wrieden/c3dpb/hardware/todo.txt

v1.2
use address mode for tmc2209
increase 100k feedback resistor gap
increase plane distance

v1.1 
add diode to power outputs 			done a
remove silkscreen lines between pinout		done a	
print polarity on top layer			done a
narrow pins on buck footprint			done a 
sot23 footprint too small			done a 
more space between some components		done a
