wrieden/c3dpb/hotend_board/c3dpb.kicad_pcb

## KiCad design hotend_board/c3dpb.kicad_pcb (2023-03-31)

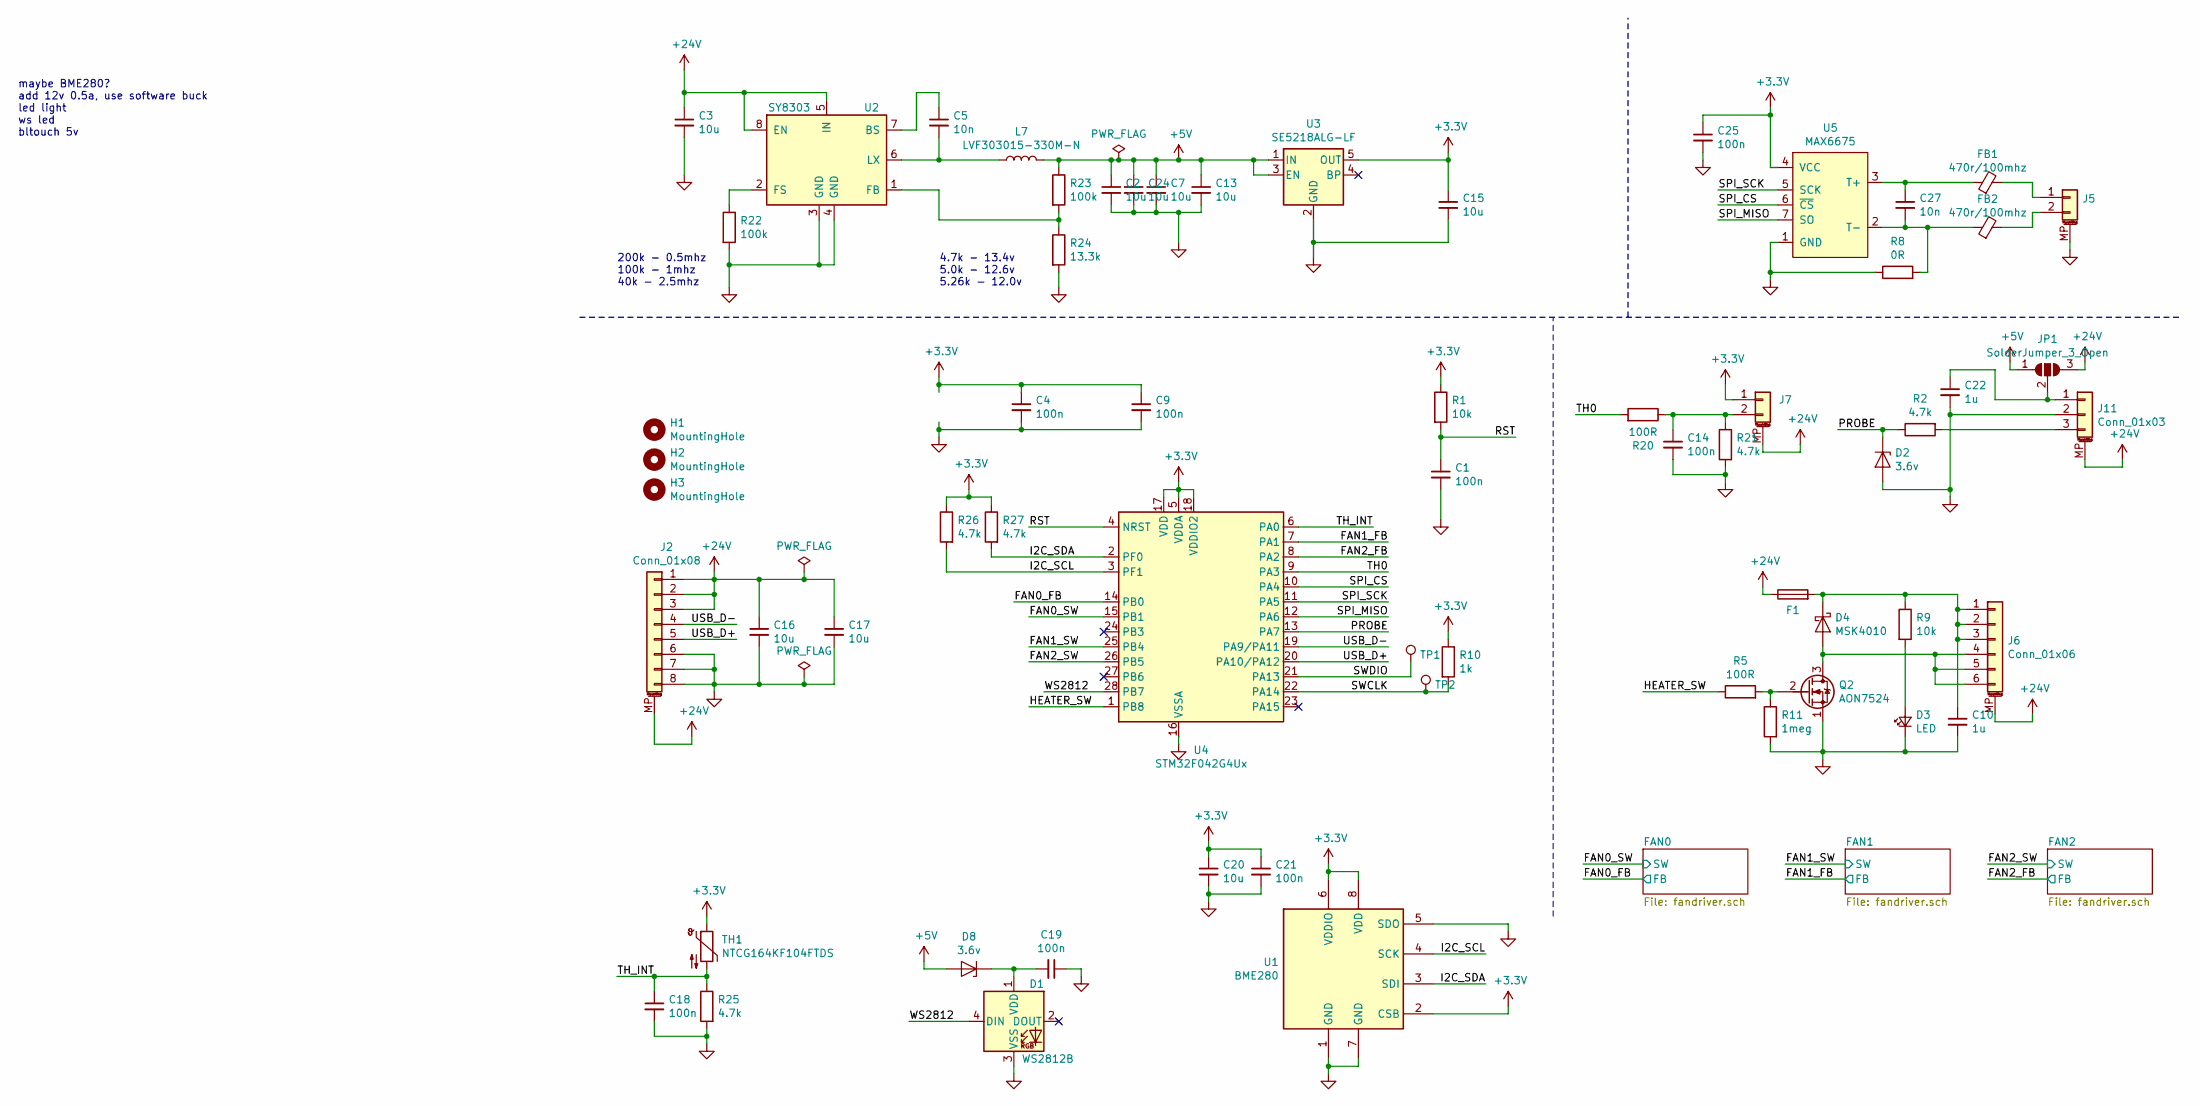
[picture p24: schematic c3dpb.sch, Kajikia - Main Sheet]

Parts:
C1, C4, C9, C14, C18, C19, C21, C25: 100n; 0603_CAP
C2, C7, C13, C15, C20, C24: 10u; 0603_CAP
C3, C16, C17: 10u; 1210_CAP
C5, C27: 10n; 0603_CAP
C10, C22: 1u; 0603_CAP
D1: WS2812B; WS2812B-MINI
D2, D8: 3.6v; 0603_DIODE
D3: LED; 0603_LED
D4: MSK4010; SOD-523_DIODE
F1: Fuse; 1206_RES
FB1, FB2: 470r/100mhz; 0603_IND
H1, H2: MountingHole; MountingHole_2.2mm_M2_ISO7380
H3: MountingHole; MountingHole_4.3mm_M4_ISO14580
J2: Conn_01x08; JST_SH_BM08B-SRSS-TB_1x08-1MP_P1.00mm_Vertical
J5, J7: Conn_01x02; JST_SH_BM02B-SRSS-TB_1x02-1MP_P1.00mm_Vertical
J6: Conn_01x06; JST_SH_BM06B-SRSS-TB_1x06-1MP_P1.00mm_Vertical
J11: Conn_01x03; JST_SH_BM03B-SRSS-TB_1x03-1MP_P1.00mm_Vertical
JP1: SolderJumper_3_Open; Solder Jumper 3P
L7: LVF303015-330M-N; 3x3mm_IND
Q2: AON7524; DFN3x3A_8L_EP1_P
R1, R9: 10k; 0603_RES
R2, R21, R25, R26, R27: 4.7k; 0603_RES
R5, R20: 100R; 0603_RES
R8: 0R; 0603_RES
R10: 1k; 0603_RES
R11: 1meg; 0603_RES
R22, R23: 100k; 0603_RES
R24: 13.3k; 0603_RES
TH1: NTCG164KF104FTDS; 0603_RES
TP1, TP2: TestPoint; TestPoint_Pad_D1.0mm
U1: BME280; Bosch_LGA-8_2.5x2.5mm_P0.65mm_ClockwisePinNumbering
U2: SY8303; TSOT-23-8
U3: SE5218ALG-LF; SOT-23-5
U4: STM32F042G4Ux; QFN-28_4x4mm_P0.5mm
U5: MAX6675; SO-8

Connections:
+3V3: C4.1, C9.1, C15.1, C20.1, C21.1, C25.1, J7.1, R1.1, R10.1, R26.1, R27.1, TH1.1, U1.2 (CSB), U1.6 (VDDIO), U1.8 (VDD), U3.5 (OUT), U4.5 (VDDA), U4.17 (VDD), U4.18 (VDDIO2), U5.4 (VCC)
+5V: C2.1, C7.1, C13.1, C24.1, D8.2 (A), JP1.1 (A), L7.2, R23.1, U3.1 (IN), U3.3 (EN)
+24V: C3.1, C16.1, C17.1, F1.1, J2.1, J2.2, J2.3, J2.MP (MountPin), J6.MP (MountPin), J7.MP (MountPin), J11.MP (MountPin), JP1.3 (B), U2.5 (IN), U2.8 (EN); also elsewhere on the board
/FAN0_FB: U4.14 (PB0); also elsewhere on the board
/FAN0_SW: U4.15 (PB1); also elsewhere on the board
/FAN1_FB: U4.7 (PA1); also elsewhere on the board
/FAN1_SW: U4.25 (PB4); also elsewhere on the board
/FAN2_FB: U4.8 (PA2); also elsewhere on the board
/FAN2_SW: U4.26 (PB5); also elsewhere on the board
/HEATER_SW: R5.1, U4.1 (PB8)
/I2C_SCL: R26.2, U1.4 (SCK), U4.3 (PF1)
/I2C_SDA: R27.2, U1.3 (SDI), U4.2 (PF0)
/PROBE: D2.1 (K), R2.1, U4.13 (PA7)
/RST: C1.1, R1.2, U4.4 (NRST)
/SPI_CS: U4.10 (PA4), U5.6 (~CS)
/SPI_MISO: U4.12 (PA6), U5.7 (SO)
/SPI_SCK: U4.11 (PA5), U5.5 (SCK)
/SWCLK: R10.2, TP2.1, U4.22 (PA14)
/SWDIO: TP1.1, U4.21 (PA13)
/TH0: R20.2, U4.9 (PA3)
/TH_INT: C18.1, R25.1, TH1.2, U4.6 (PA0)
/USB_D+: J2.5, U4.20 (PA10/PA12)
/USB_D-: J2.4, U4.19 (PA9/PA11)
/WS2812: D1.4 (DIN), U4.28 (PB7)
GND: C1.2, C2.2, C3.2, C4.2, C7.2, C9.2, C10.2, C13.2, C14.2, C15.2, C16.2, C17.2, C18.2, C19.1, C20.2, C21.2, C22.2, C24.2, C25.2, D1.3 (VSS), D2.2 (A), D3.1 (K), J2.6, J2.7, J2.8, J5.MP (MountPin), J11.2, Q2.1 (S), R8.1, R11.2, R21.2, R22.2, R24.2, R25.2, U1.1 (GND), U1.5 (SDO), U1.7 (GND), U2.3 (GND), U2.4 (GND), U3.2 (GND), U4.16 (VSSA), U5.1 (GND); also elsewhere on the board
unnamed: C5.1, U2.7 (BS)
unnamed: C5.2, L7.1, U2.6 (LX)
unnamed: C10.1, D4.1 (K), F1.2, J6.1, J6.2, J6.3, R9.1
unnamed: C14.1, J7.2, R20.1, R21.1
unnamed: C19.2, D1.1 (VDD), D8.1 (K)
unnamed: C22.1, J11.1, JP1.2 (C)
unnamed: C27.1, FB1.1, U5.3 (T+)
unnamed: C27.2, FB2.1, R8.2, U5.2 (T-)
unnamed: D3.2 (A), R9.2
unnamed: D4.2 (A), J6.4, J6.5, J6.6, Q2.3 (D)
unnamed: FB1.2, J5.1
unnamed: FB2.2, J5.2
unnamed: J11.3, R2.2
unnamed: Q2.2 (G), R5.2, R11.1
unnamed: R22.1, U2.2 (FS)
unnamed: R23.2, R24.1, U2.1 (FB)

Notes on the sheet:
maybe BME280? add 12v 0.5a, use software buck led light ws led bltouch 5v
4.7k - 13.4v 5.0k - 12.6v 5.26k - 12.0v
200k - 0.5mhz 100k - 1mhz 40k - 2.5mhz

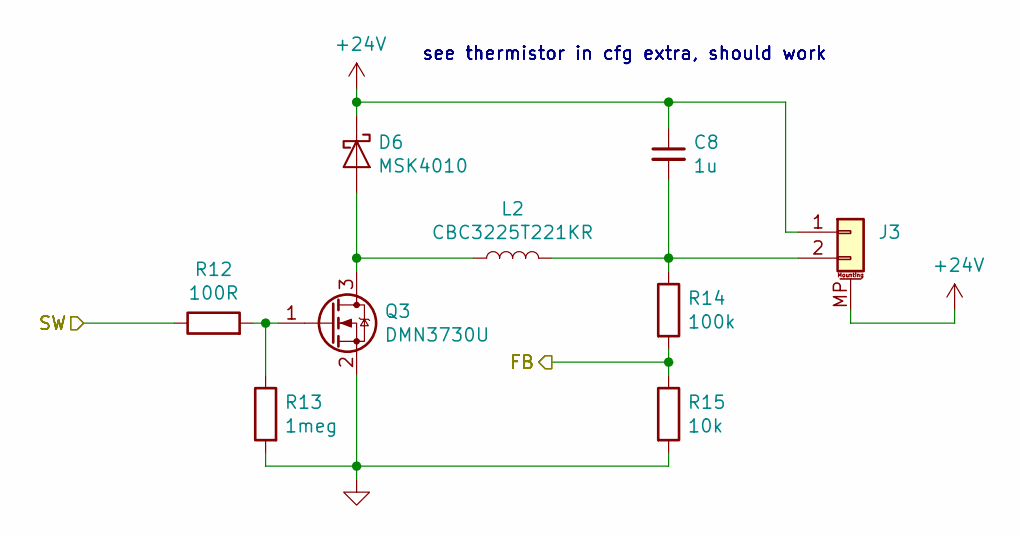
[picture p25: schematic fandriver.sch]

Parts:
C6: 1u; 0603_CAP
D5: MSK4010; SOD-523_DIODE
J1: Conn_01x02; JST_SH_BM02B-SRSS-TB_1x02-1MP_P1.00mm_Vertical
L1: CBC3225T221KR; 1210_CAP
Q1: DMN3730U; SOT-23
R3: 100R; 0603_RES
R4: 1meg; 0603_RES
R6: 100k; 0603_RES
R7: 10k; 0603_RES

Connections:
+24V: C6.1, D5.1 (K), J1.1, J1.MP (MountPin); also elsewhere on the board
/FAN0_FB: R6.2, R7.1; also elsewhere on the board
/FAN0_SW: R3.1; also elsewhere on the board
GND: Q1.2 (S), R4.2, R7.2; also elsewhere on the board
unnamed: C6.2, J1.2, L1.2, R6.1
unnamed: D5.2 (A), L1.1, Q1.3 (D)
unnamed: Q1.1 (G), R3.2, R4.1

Parts of its further copies:
C8, C11: 1u; 0603_CAP
D6, D7: MSK4010; SOD-523_DIODE
J3, J4: Conn_01x02; JST_SH_BM02B-SRSS-TB_1x02-1MP_P1.00mm_Vertical
L2, L3: CBC3225T221KR; 1210_CAP
Q3, Q4: DMN3730U; SOT-23
R12, R16: 100R; 0603_RES
R13, R17: 1meg; 0603_RES
R14, R18: 100k; 0603_RES
R15, R19: 10k; 0603_RES

Connections of its further copies:
+24V: C8.1, C11.1, D6.1 (K), D7.1 (K), J3.1, J3.MP (MountPin), J4.1, J4.MP (MountPin); also elsewhere on the board
/FAN1_FB: R14.2, R15.1; also elsewhere on the board
/FAN1_SW: R12.1; also elsewhere on the board
/FAN2_FB: R18.2, R19.1; also elsewhere on the board
/FAN2_SW: R16.1; also elsewhere on the board
GND: Q3.2 (S), Q4.2 (S), R13.2, R15.2, R17.2, R19.2; also elsewhere on the board
unnamed: C8.2, J3.2, L2.2, R14.1
unnamed: C11.2, J4.2, L3.2, R18.1
unnamed: D6.2 (A), L2.1, Q3.3 (D)
unnamed: D7.2 (A), L3.1, Q4.3 (D)
unnamed: Q3.1 (G), R12.2, R13.1
unnamed: Q4.1 (G), R16.2, R17.1

Notes on the sheet:
see thermistor in cfg extra, should work

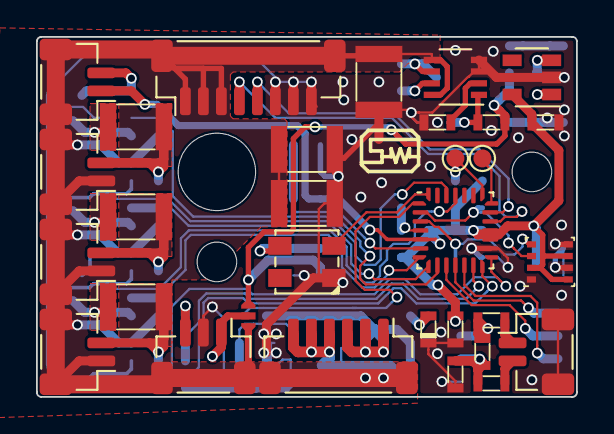
[picture p26: board hotend_board/c3dpb.kicad_pcb from above]

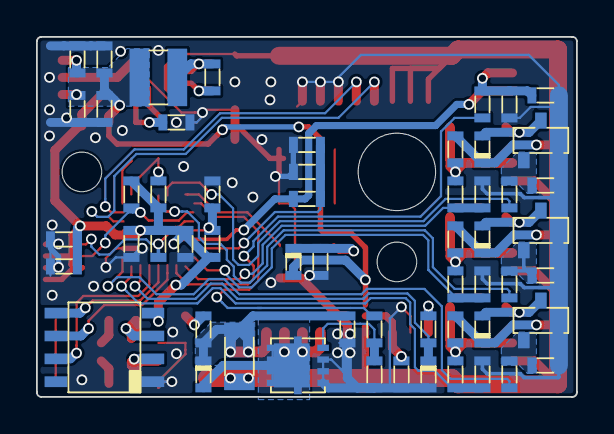
[picture p27: board hotend_board/c3dpb.kicad_pcb from below]

Board: 2 copper layers, 30.0 x 20.0 mm, 90 parts (56 on the bottom side), 50 nets.
