wrieden/c3dpb/hotend_board_mosquito/c3dpb.kicad_pcb

## KiCad design hotend_board_mosquito/c3dpb.kicad_pcb (2023-03-31)

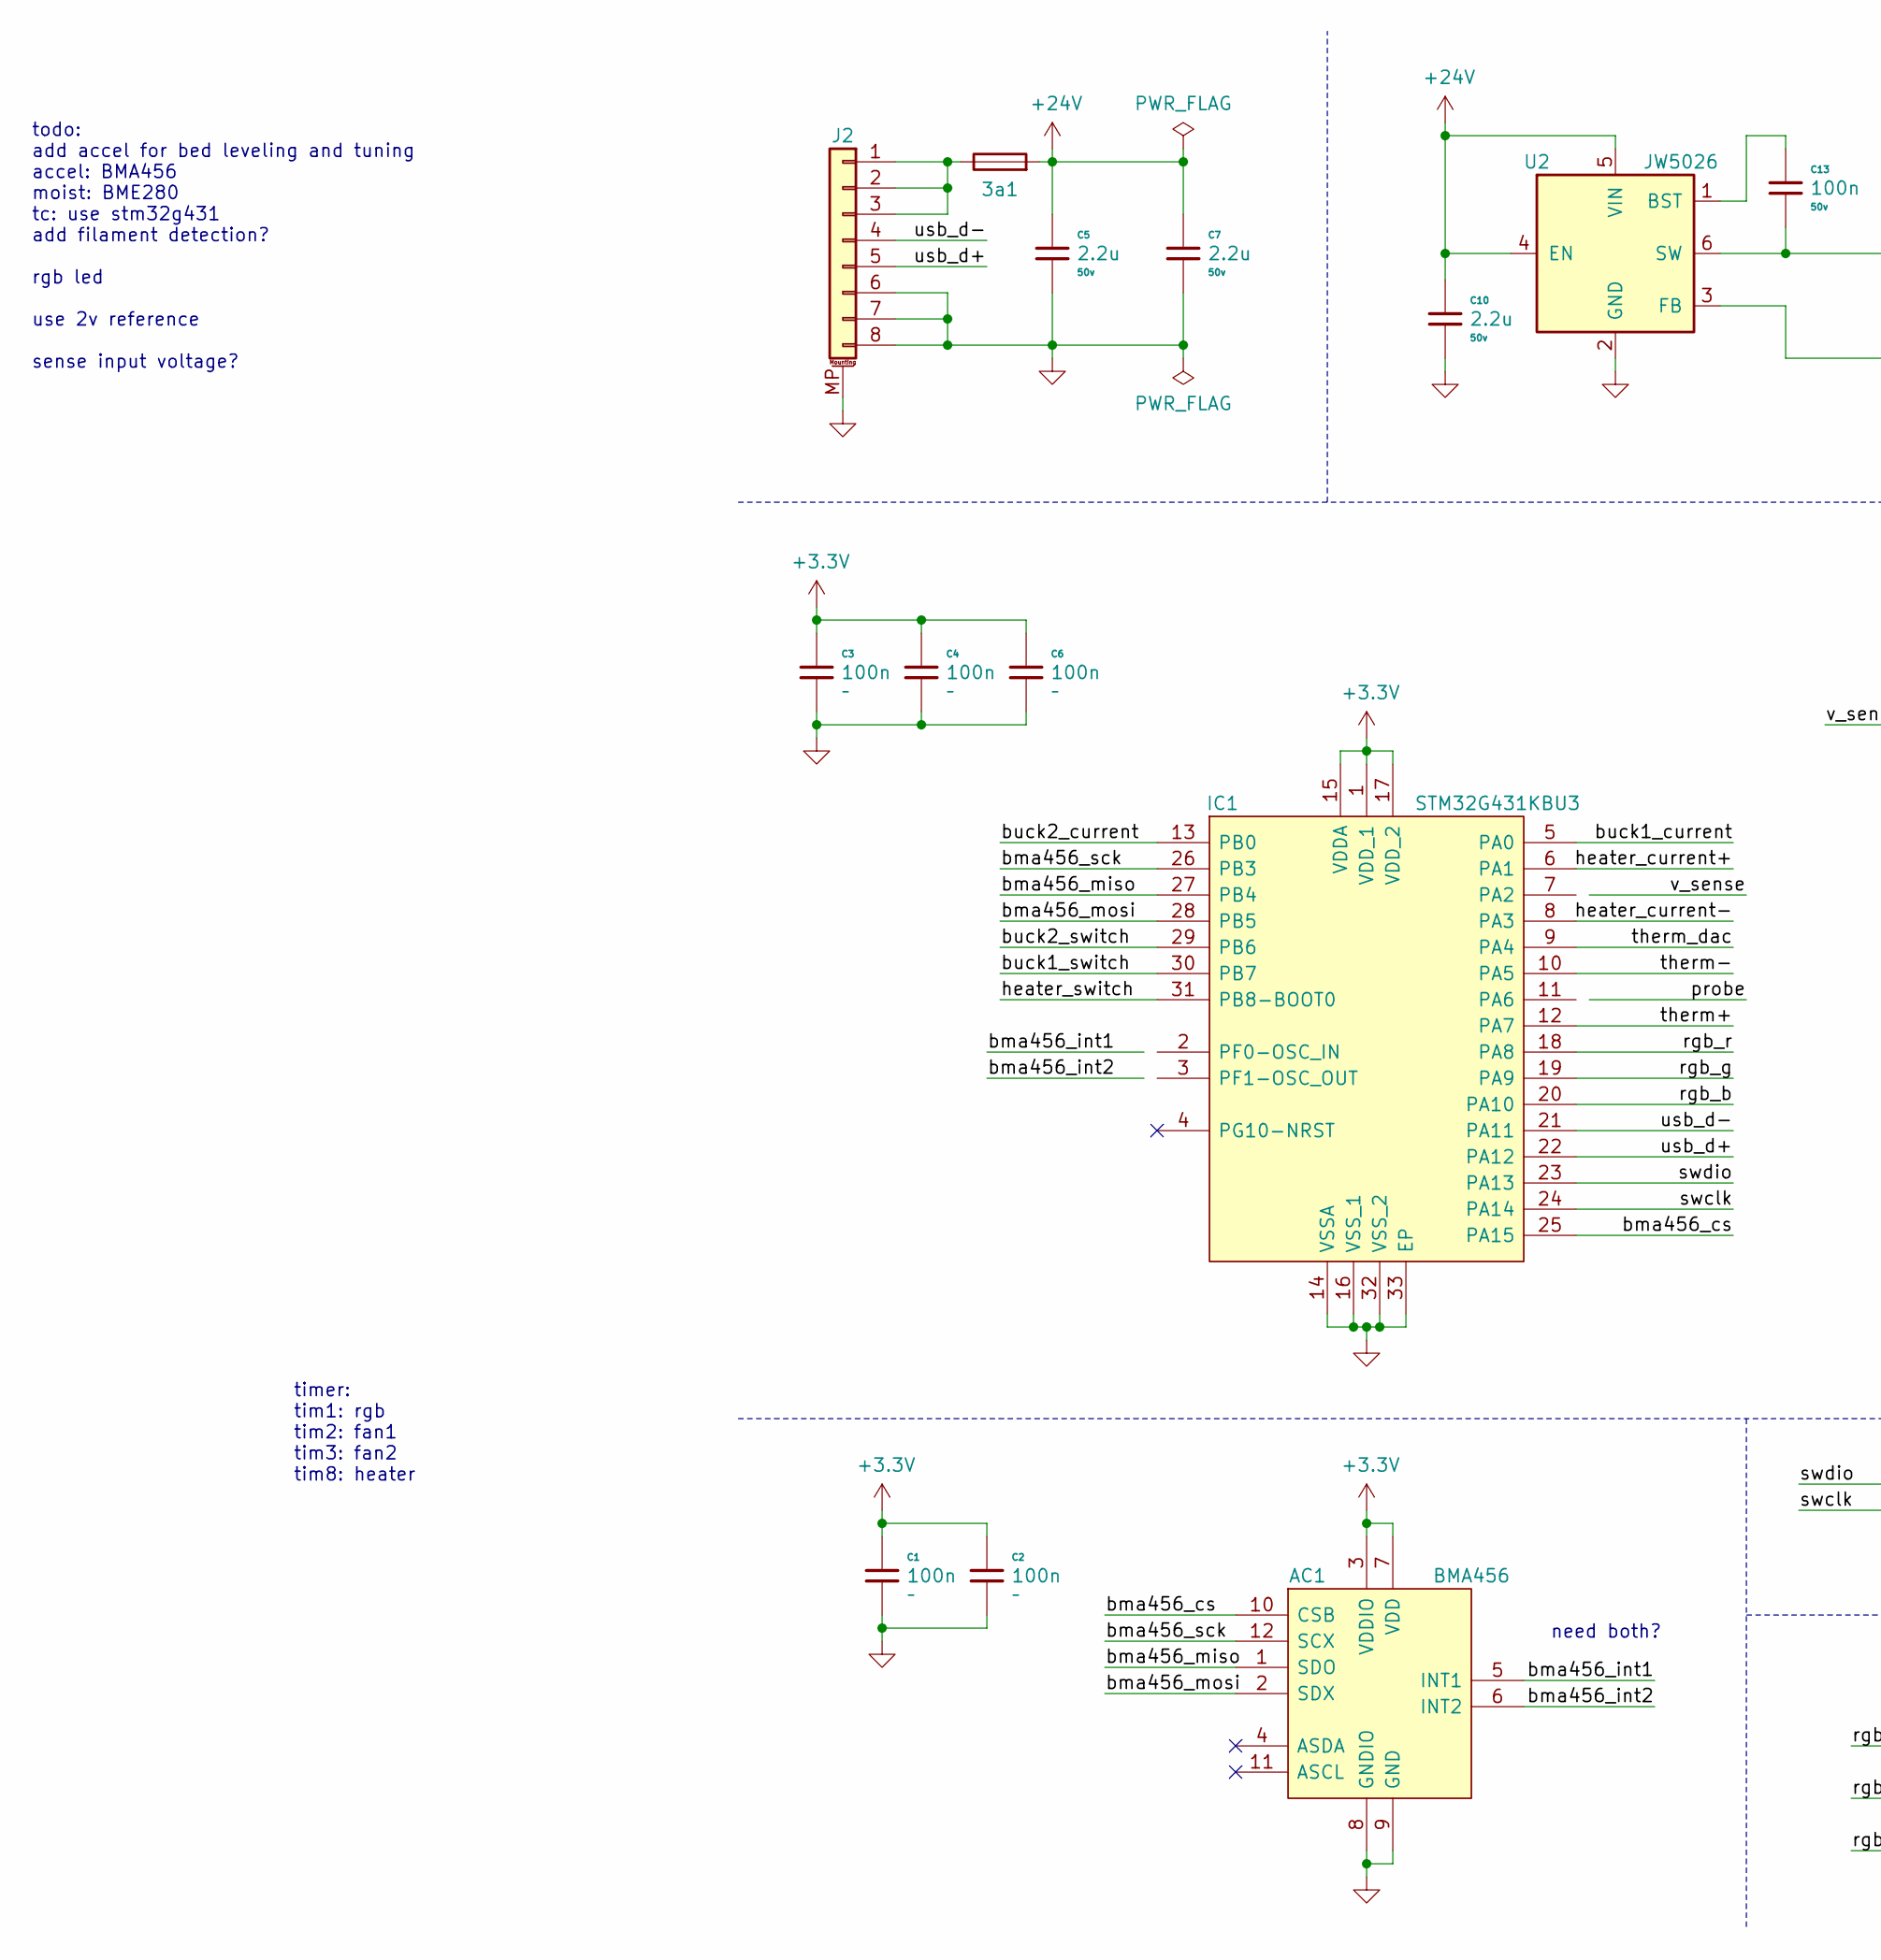
[picture p28: schematic c3dpb.sch, Kajikia - Main Sheet, part in row 1, column 1]

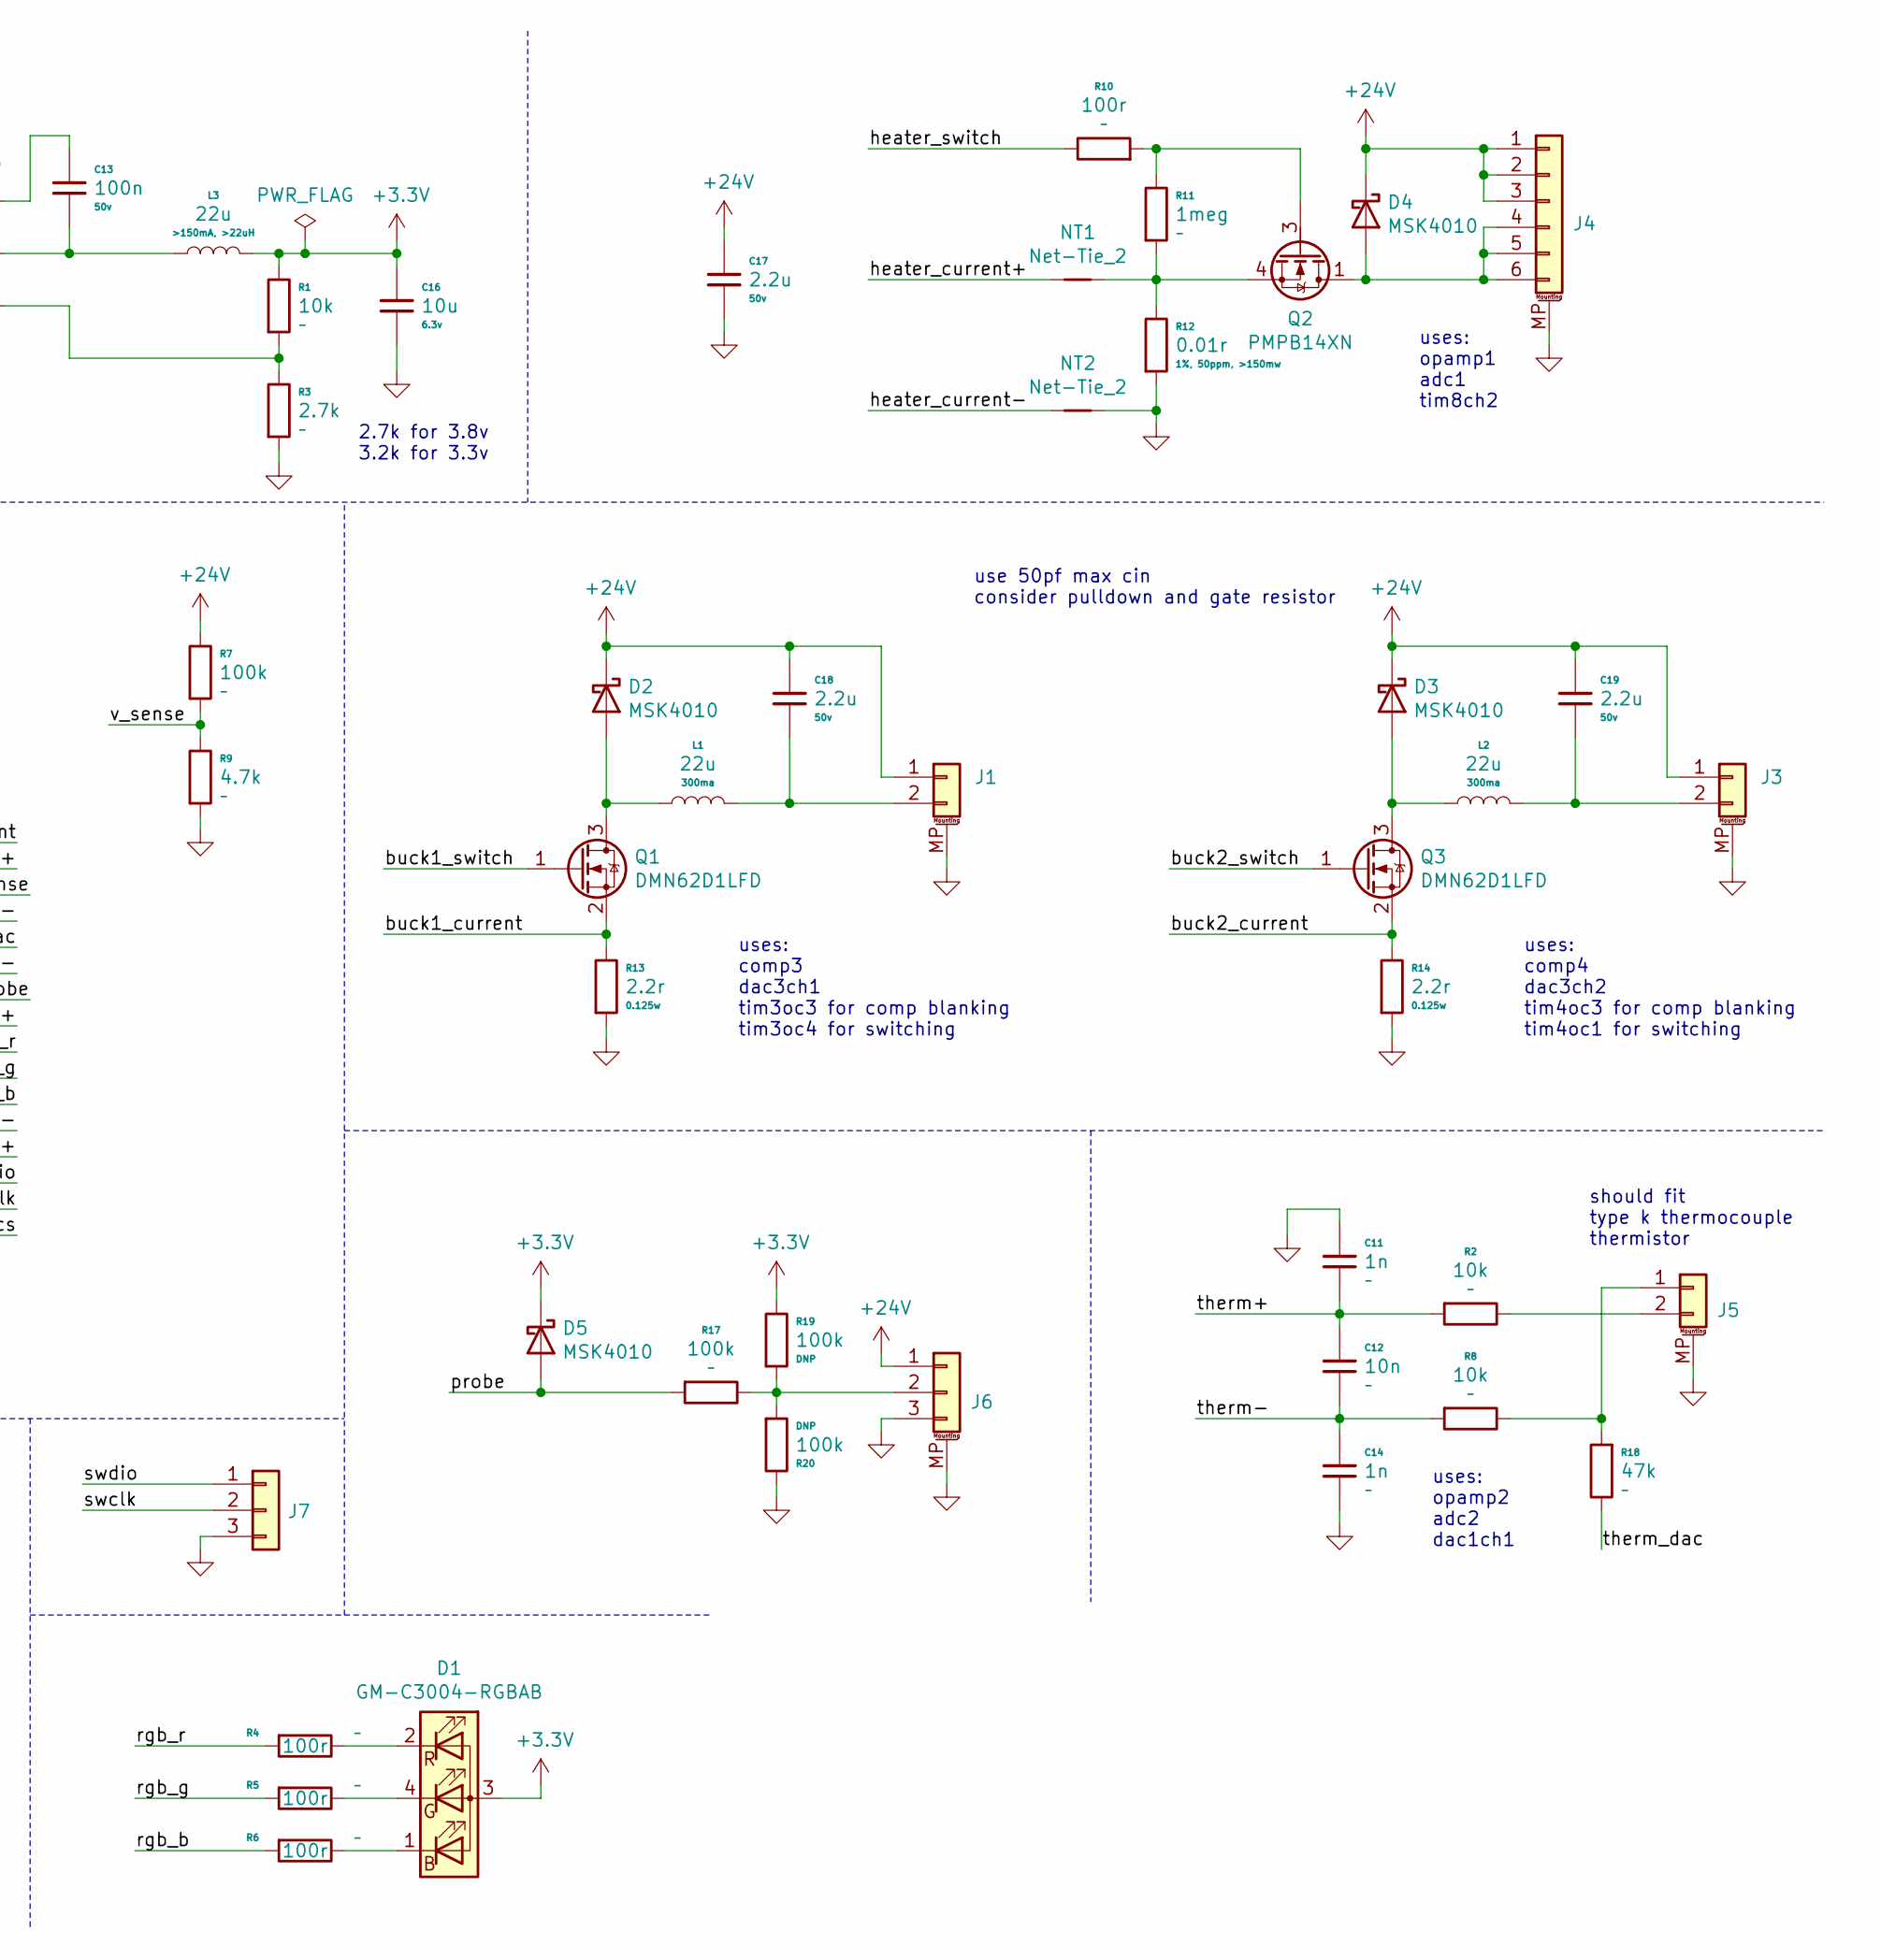
[picture p29: schematic c3dpb.sch, Kajikia - Main Sheet, part in row 1, column 2]

Parts:
3a1: Fuse; 1206_RES
AC1: BMA456; BOSCH_LGA-12
C1, C2, C3, C4, C6, C13: 100n; 0402_CAP
C5, C7, C10, C17, C18, C19: 2.2u; 0603_CAP
C11, C14: 1n; 0402_CAP
C12: 10n; 0402_CAP
C16: 10u; 0402_CAP
D1: GM-C3004-RGBAB
D2, D3, D4, D5: MSK4010; SOD-523_DIODE
IC1: STM32G431KBU3; QFN-32-1EP_5x5mm_P0.5mm_EP3.6x3.6mm
J1, J3: Conn_01x02; JST_SH_BM02B-SRSS-TB_1x02-1MP_P1.00mm_Vertical
J2: Conn_01x08; JST_SH_BM08B-SRSS-TB_1x08-1MP_P1.00mm_Vertical
J4: Conn_01x06_MountingPin; JST_SH_BM06B-SRSS-TB_1x06-1MP_P1.00mm_Vertical
J5: Conn_01x02_MountingPin; JST_SH_BM02B-SRSS-TB_1x02-1MP_P1.00mm_Vertical
J6: Conn_01x03_MountingPin; JST_SH_BM03B-SRSS-TB_1x03-1MP_P1.00mm_Vertical
J7: Conn_01x03; pads_3x1mm
L1, L2, L3: 22u; 0805_IND
NT1, NT2: Net-Tie_2; nettie-1.27
Q1, Q3: DMN62D1LFD; U-DFN1212-3
Q2: PMPB14XN; Diodes_UDFN2020-6_Type-F
R1, R2, R8: 10k; 0402_RES
R3: 2.7k; 0402_RES
R4, R5, R6, R10: 100r; 0402_RES
R7, R17, R19, R20: 100k; 0402_RES
R9: 4.7k; 0402_RES
R11: 1meg; 0402_RES
R12: 0.01r; 0603_RES
R13, R14: 2.2r; 0603_RES
R18: 47k; 0402_RES
U2: JW5026; SOT-23-6

Connections:
+3V3: AC1.3 (VDDIO), AC1.7 (VDD), C1.1, C2.1, C3.1, C4.1, C6.1, C16.1, D1.3 (A), D5.1 (K), IC1.1 (VDD_1), IC1.15 (VDDA), IC1.17 (VDD_2), L3.2, R1.1, R19.1
+24V: 3a1.2, C5.1, C7.1, C10.1, C17.1, C18.1, C19.1, D2.1 (K), D3.1 (K), D4.1 (K), J1.1, J3.1, J4.1, J4.2, J4.3, J6.1, R7.1, U2.4 (EN), U2.5 (VIN)
/bma456_cs: AC1.10 (CSB), IC1.25 (PA15)
/bma456_int1: AC1.5 (INT1)
/bma456_int2: AC1.6 (INT2)
/bma456_miso: AC1.1 (SDO), IC1.27 (PB4)
/bma456_mosi: AC1.2 (SDX), IC1.28 (PB5)
/bma456_sck: AC1.12 (SCX), IC1.26 (PB3)
/buck1_current: IC1.5 (PA0), Q1.2 (S), R13.1
/buck1_switch: IC1.30 (PB7), Q1.1 (G)
/buck2_current: IC1.13 (PB0), Q3.2 (S), R14.1
/buck2_switch: IC1.29 (PB6), Q3.1 (G)
/heater_current+: IC1.6 (PA1), NT1.2
/heater_current-: IC1.8 (PA3), NT2.2
/heater_switch: IC1.31 (PB8-BOOT0), R10.1
/probe: D5.2 (A), R17.2
/rgb_b: IC1.20 (PA10), R6.2
/rgb_g: IC1.19 (PA9), R5.2
/rgb_r: IC1.18 (PA8), R4.2
/swclk: IC1.24 (PA14), J7.2
/swdio: IC1.23 (PA13), J7.1
/therm+: C11.2, C12.1, IC1.12 (PA7), R2.2
/therm-: C12.2, C14.1, IC1.10 (PA5), R8.2
/therm_dac: IC1.9 (PA4), R18.1
/usb_d+: IC1.22 (PA12), J2.5
/usb_d-: IC1.21 (PA11), J2.4
/v_sense: R7.2, R9.1
GND: AC1.8 (GNDIO), AC1.9 (GND), C1.2, C2.2, C3.2, C4.2, C5.2, C6.2, C7.2, C10.2, C11.1, C14.2, C16.2, C17.2, IC1.14 (VSSA), IC1.16 (VSS_1), IC1.32 (VSS_2), IC1.33 (EP), J1.MP (MountPin), J2.6, J2.7, J2.8, J2.MP (MountPin), J3.MP (MountPin), J4.MP (MountPin), J5.MP (MountPin), J6.3, J6.MP (MountPin), J7.3, NT2.1, R3.2, R9.2, R12.2, R13.2, R14.2, R20.1, U2.2 (GND)
unnamed: 3a1.1, J2.1, J2.2, J2.3
unnamed: C13.1, U2.1 (BST)
unnamed: C13.2, L3.1, U2.6 (SW)
unnamed: C18.2, J1.2, L1.2
unnamed: C19.2, J3.2, L2.2
unnamed: D1.1 (BK), R6.1
unnamed: D1.2 (RK), R4.1
unnamed: D1.4 (GK), R5.1
unnamed: D2.2 (A), L1.1, Q1.3 (D)
unnamed: D3.2 (A), L2.1, Q3.3 (D)
unnamed: D4.2 (A), J4.4, J4.5, J4.6, Q2.1 (D), Q2.2 (D), Q2.5 (D), Q2.6 (D), Q2.7 (D)
unnamed: J5.1, R8.1, R18.2
unnamed: J5.2, R2.1
unnamed: J6.2, R17.1, R19.2, R20.2
unnamed: NT1.1, Q2.4 (S), Q2.8 (S), R11.2, R12.1
unnamed: Q2.3 (G), R10.2, R11.1
unnamed: R1.2, R3.1, U2.3 (FB)

Notes on the sheet:
todo: add accel for bed leveling and tuning accel: BMA456 moist: BME280 tc: use stm32g431 add filament detection? rgb led use 2v reference sense input voltage?
timer: tim1: rgb tim2: fan1 tim3: fan2 tim8: heater
should fit type k thermocouple thermistor
need both?
use 50pf max cin consider pulldown and gate resistor
uses: comp4 dac3ch2 tim4oc3 for comp blanking tim4oc1 for switching
uses: comp3 dac3ch1 tim3oc3 for comp blanking tim3oc4 for switching
uses: opamp2 adc2 dac1ch1
uses: opamp1 adc1 tim8ch2
2.7k for 3.8v 3.2k for 3.3v

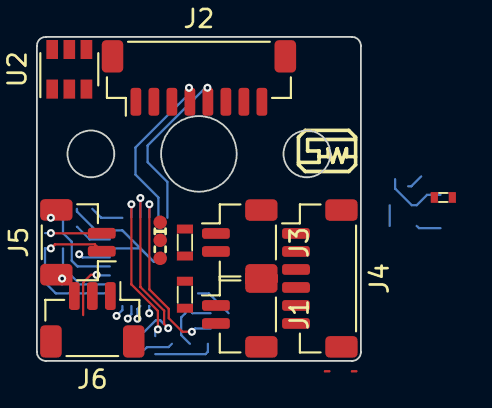
[picture p30: board hotend_board_mosquito/c3dpb.kicad_pcb from above]

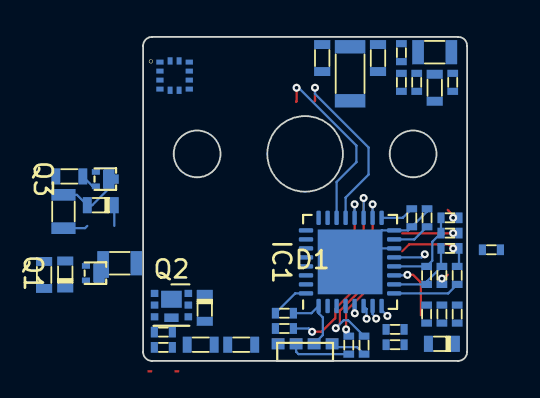
[picture p31: board hotend_board_mosquito/c3dpb.kicad_pcb from below]

Board: 4 copper layers, 18.0 x 18.0 mm, 58 parts (45 on the bottom side), 43 nets.
