wrieden/c3dpb/hardware/c3dpb.kicad_pcb

## KiCad design hardware/c3dpb.kicad_pcb (2020-02-15)

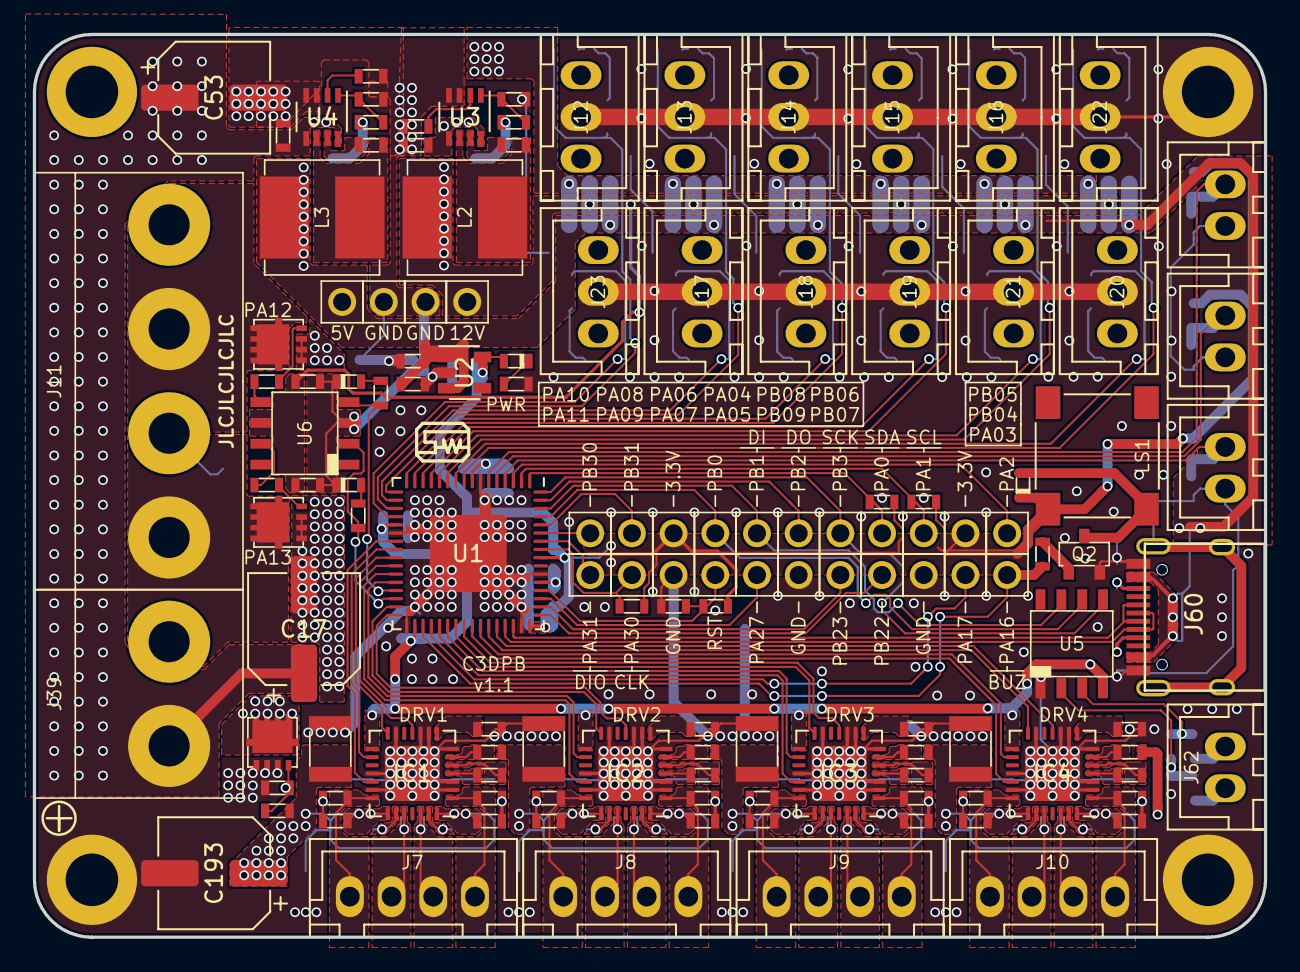
[picture p32: board hardware/c3dpb.kicad_pcb from above]

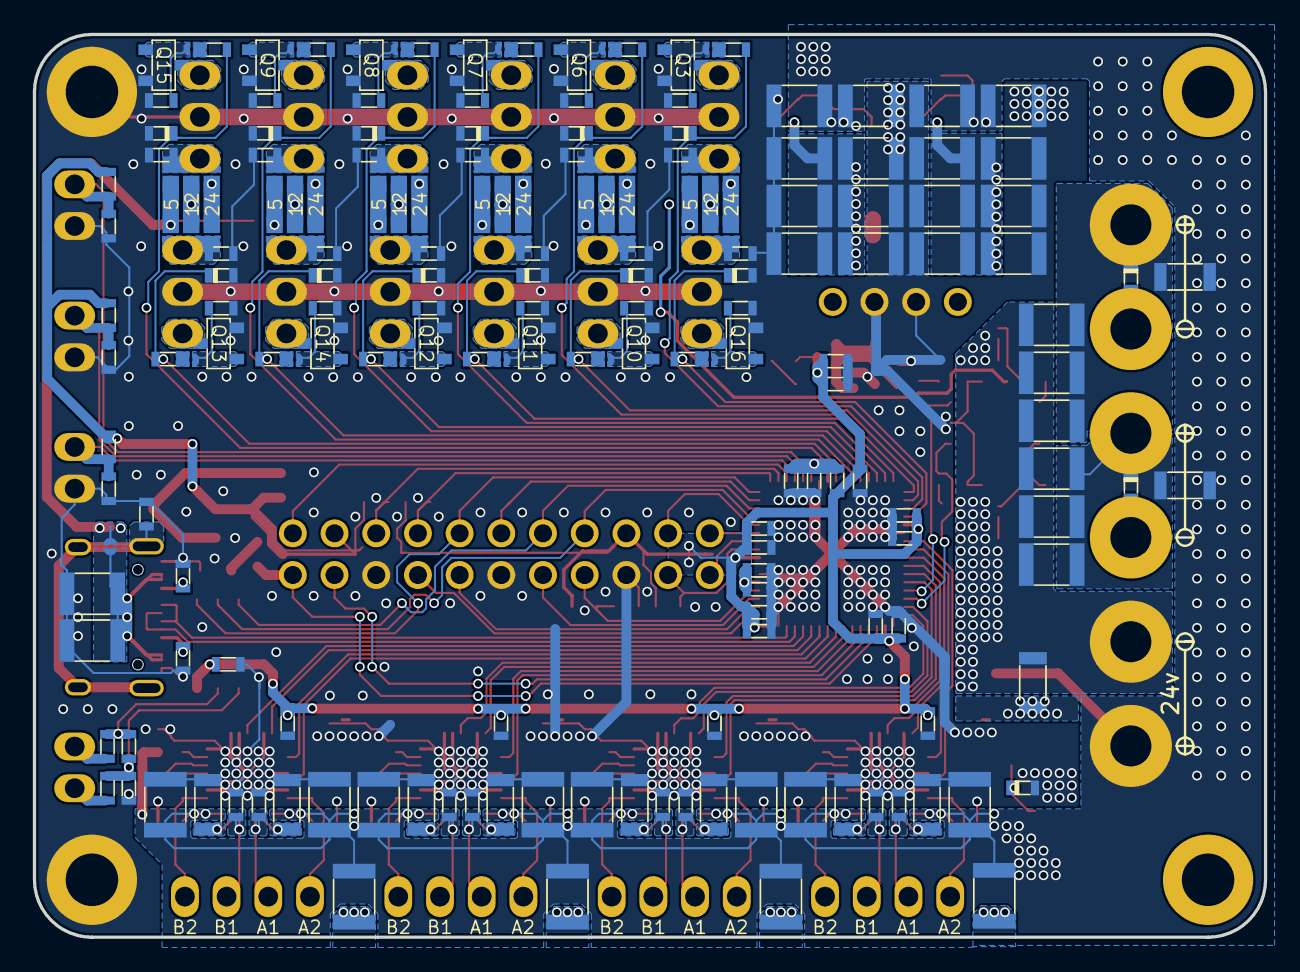
[picture p33: board hardware/c3dpb.kicad_pcb from below]

Board: 2 copper layers, 75.0 x 55.0 mm, 325 parts (189 on the bottom side), 179 nets.

Parts:
C1, C3, C5, C6, C8, C10, C11, C12, C16, C26, C45, C46, C50, C54, C58, C66, C79, C83, C86, C94, C97, C105, C108, C116, C117, C118, C119: 100n; 0603_CAP
C2, C4, C7, C9, C13, C14, C15, C18, C19, C20, C21, C22, C49, C59, C60, C61, C85, C96, C107: 10u; 0603_CAP
C17, C53, C193: 220u; CP_Elec_6.3x7.7
C23, C24, C25, C27, C47, C52, C55, C56, C57, C62, C63, C65, C84, C88, C95, C99, C106, C110, C120, C121, C122, C123, C124, C125, C126, C127: 4.7u; 1210_CAP
C28, C37: 10n; 0603_CAP
C30, C31, C32, C33, C34, C35, C36, C38, C40, C41, C42, C43, C44, C89: 22u; 1210_CAP
C48, C51, C87, C98, C109: 22n; 0603_CAP
C64, C67, C68, C69, C70, C71, C72, C73, C74, C75, C76, C77: 1u; 0603_CAP
C78, C80, C81, C82, C90, C91, C92, C93, C101, C102, C103, C104, C112, C113, C114, C115: 470p; 0603_CAP
D1: 16v; SOD-523_DIODE
D2, D18, D19: MSK4010; SOD-523_DIODE
D3, D4, D5: LED; 0603_LED
D6, D7, D8, D9, D10, D11, D12, D13, D14, D15, D16, D17: 3.6v; SOD-523_DIODE
F1, F2, F3: Fuse; 1206_RES
FB1, FB2, FB3, FB4: 470r/100mhz; 0603_IND
H1, H2, H3, H4: M3; MountingHole_3.2mm_M3_ISO14580_Pad
IC1, IC2, IC3, IC4: TMC2209; QFN-28-1EP_5x5mm_P0.5mm_EP3.35x3.35mm
J1, J2, J3, J4, J5, J6, J24, J25, J26, J27, J28, J29, J30, J31, J32, J33, J34, J45, J48, J49, J56, J57, J58, J59, J94, J95: Conn_01x01; PinHeader_2.54mm_1P
J7, J8, J9, J10: Conn_01x04; JST_XH_4P
J11: Screw_Terminal_01x04; KF635-4P
J12, J13, J14, J15, J16, J17, J18, J19, J20, J21, J22, J23: Conn_01x03; JST_XH_3P
J39: Screw_Terminal_01x02; KF635-2P
J60: USB_C_Receptacle; TYPE-C-31-M-12
J62, J71, J72, J73: Conn_01x02; JST_XH_2P
JP2, JP3, JP5, JP6, JP8, JP9, JP11, JP12, JP14, JP15, JP17, JP19, JP20, JP22, JP23, JP25, JP26, JP28, JP29, JP31, JP32, JP34, JP35, JP37, JP38: SolderJumper_2_Open; Solder Jumper 2P
JP4, JP7, JP10, JP13, JP18, JP21, JP24, JP27, JP30, JP33, JP36, JP39: SolderJumper_4_Open; SolderJumper_JST
L2, L3: BCIHP0750-6R8M; 7x7mm_IND
LS1: Buzzer; Buzzer-7525
Q1, Q4, Q5: AON7418; DFN3x3A_8L_EP1_P
Q2, Q3, Q6, Q7, Q8, Q9, Q10, Q11, Q12, Q13, Q14, Q15, Q16: AO3402; SOT-23
R1, R4, R5: 10k; 0603_RES
R2, R3: 10R; 0603_RES
R6, R18, R21, R22, R30, R32, R34, R36, R37, R39, R41, R42, R44, R46, R47, R48, R50, R51, R53, R55: 4.7k; 0603_RES
R7, R9, R31, R33, R35, R38, R40, R43, R45, R49, R52, R54, R56: 1meg; 0603_RES
R8, R11, R12, R15, R17: 100k; 0603_RES
R10, R14, R16: 1k; 0603_RES
R13: 13.3k; 0603_RES
R19, R20, R24, R25, R26, R27, R28, R29: 120m; 1206_RES
R23: 0R; 0603_RES
U1: ATSAMD51J19A-M; QFN-64-1EP_9x9mm_P0.5mm_EP4.7x4.7mm
U2: SE5218ALG-LF; SOT-23-5
U3, U4: SY8303; TSOT-23-8
U5: MAX6675; SO-8
U6: IR4427S; SO-8

Connections:
+3V3: C2.1, C4.1, C6.1, C7.1, C8.1, C9.1, C10.1, C11.1, C14.1, C21.1, C22.1, C45.1, C54.2, C58.2, C66.2, C79.2, D2.1, D4.2, FB2.2, IC1.15, IC2.15, IC3.15, IC4.15, J94.1, J95.1, LS1.1, R1.1, R10.1, R37.1, R42.1, R46.1, R48.1, R50.1, U1.21, U1.34, U1.48, U1.56, U2.5, U5.4
+5V: C18.1, C20.1, C33.1, C34.1, C38.1, C40.1, C43.1, C44.1, J48.1, JP4.2, JP7.2, JP10.2, JP13.2, JP15.2, JP18.2, JP21.4, JP24.4, JP27.4, JP30.4, JP33.4, JP36.2, JP39.4, L3.2, R12.1, U2.1, U2.3
+12V: C15.1, C16.1, C30.1, C32.1, C35.1, C36.1, C41.1, C42.1, J45.1, JP4.3, JP7.3, JP10.3, JP13.3, JP18.3, JP21.3, JP24.3, JP27.3, JP30.3, JP33.3, JP36.3, JP39.3, L2.2, R17.1, U6.6
+24V: C3.1, C5.1, C17.1, C23.1, C24.1, C25.1, C27.1, C46.2, C47.1, C50.2, C52.1, C53.1, C83.2, C84.1, C86.2, C88.1, C94.2, C95.1, C97.2, C99.1, C105.2, C106.1, C108.2, C110.1, C116.2, C117.2, C118.2, C119.2, C120.1, C121.1, C122.1, C123.1, C124.1, C125.1, C126.1, C127.1, C193.1, F2.2, F3.2, IC1.22, IC1.28, IC2.22, IC2.28, IC3.22, IC3.28, IC4.22, IC4.28, J39.2, JP4.4, JP7.4, JP10.4, JP13.4, JP18.4, JP21.2, JP24.2, JP27.2, JP30.2, JP33.2, JP36.4, JP39.2, R8.1, U3.5, U3.8, U4.5, U4.8
/BUZZER: J6.1, R16.2, U1.35
/DRV1_DIAG: IC1.11, U1.26
/DRV1_DIR: IC1.19, U1.23
/DRV1_STEP: IC1.16, U1.24
/DRV1_UART: IC1.14, U1.25
/DRV2_DIAG: IC2.11, U1.32
/DRV2_DIR: IC2.19, U1.27
/DRV2_STEP: IC2.16, U1.28
/DRV2_UART: IC2.14, U1.31
/DRV3_DIAG: IC3.11, U1.40
/DRV3_DIR: IC3.19, U1.37
/DRV3_STEP: IC3.16, U1.38
/DRV3_UART: IC3.14, U1.39
/DRV4_DIAG: IC4.11, U1.44
/DRV4_DIR: IC4.19, U1.41
/DRV4_STEP: IC4.16, U1.42
/DRV4_UART: IC4.14, U1.43
/I2C_SCL: J4.1, R37.2, U1.2
/I2C_SDA: J3.1, R42.2, U1.1
/IO1: D6.1, R6.1, U1.19
/IO2: D7.1, R30.1, U1.17
/IO3: D8.1, R32.1, U1.15
/IO4: D9.1, R34.1, U1.13
/IO5: D10.1, R36.1, U1.11
/IO6: D16.1, R53.1, U1.9
/IO7: D17.1, R55.1, U1.20
/IO8: D11.1, R39.1, U1.18
/IO9: D12.1, R41.1, U1.16
/IO10: D13.1, R44.1, U1.14
/IO11: D15.1, R51.1, U1.12
/IO12: D14.1, R47.1, U1.10
/POW1: R5.1, U1.30, U6.2
/POW2: R4.1, U1.29, U6.4
/RST: C1.1, J24.1, R1.2, U1.52
/SPI_CS: J27.1, U1.61, U5.6
/SPI_MISO: J28.1, U1.62, U5.7
/SPI_MOSI: J29.1, U1.63
/SPI_SCK: J30.1, U1.64, U5.5
/SWCLK: J1.1, R10.2, U1.57
/SWDIO: J2.1, U1.58
/TH1: C60.1, J72.1, R48.2, U1.6
/TH2: C61.1, J71.1, R50.2, U1.5
/TH3: C59.1, J73.1, R46.2, U1.4
/USB_D+: J60.A6, J60.B6, U1.46
/USB_D-: J60.A7, J60.B7, U1.45
/VDDANA: C19.1, C26.1, FB2.1, U1.8
/VDDCORE: C12.1, C13.1, U1.53
DCIN-: C17.2, C55.2, C56.2, C57.2, C62.2, C63.2, C65.2, F1.2, J39.1, Q4.1, Q5.1
GND: C1.2, C2.2, C3.2, C4.2, C5.2, C6.2, C7.2, C8.2, C9.2, C10.2, C11.2, C12.2, C13.2, C14.2, C15.2, C16.2, C18.2, C19.2, C20.2, C21.2, C22.2, C23.2, C24.2, C25.2, C26.2, C27.2, C30.2, C31.2, C32.2, C33.2, C34.2, C35.2, C36.2, C38.2, C40.2, C41.2, C42.2, C43.2, C44.2, C45.2, C46.1, C47.2, C49.2, C52.2, C53.2, C54.1, C58.1, C59.2, C60.2, C61.2, C64.2, C66.1, C67.2, C68.2, C69.2, C70.2, C71.2, C72.2, C73.2, C74.2, C75.2, C76.2, C77.2, C78.2, C79.1, C80.2, C81.2, C82.2, C83.1, C84.2, C85.2, C88.2, C89.2, C90.2, C91.2, C92.2, C93.2, C94.1, C95.2, C96.2, C99.2, C101.2, C102.2, C103.2, C104.2, C105.1, C106.2, C107.2, C110.2, C112.2, C113.2, C114.2, C115.2, C116.1, C117.1, C118.1, C119.1, C120.2, C121.2, C122.2, C123.2, C124.2, C125.2, C126.2, C127.2, C193.2, D1.2, D3.1, D5.1, D6.2, D7.2, D8.2, D9.2, D10.2, D11.2, D12.2, D13.2, D14.2, D15.2, D16.2, D17.2, FB1.1, H2.1, H3.1, H4.1, IC1.2, IC1.3, IC1.7, IC1.9, IC1.10, IC1.13, IC1.18, IC1.20, IC1.29, IC2.2, IC2.3, IC2.7, IC2.9, IC2.10, IC2.13, IC2.18, IC2.20, IC2.29, IC3.2, IC3.3, IC3.7, IC3.9, IC3.10, IC3.13, IC3.18, IC3.20, IC3.29, IC4.2, IC4.3, IC4.7, IC4.9, IC4.10, IC4.13, IC4.18, IC4.20, IC4.29, J12.2, J13.2, J14.2, J15.2, J16.2, J17.2, J18.2, J19.2, J20.2, J21.2, J22.2, J23.2, J49.1, J56.1, J57.1, J58.1, J59.1, J60.A1, J60.A12, J60.B1, J60.B12, J71.2, J72.2, J73.2, Q1.1, Q2.2, Q3.2, Q6.2, Q7.2, Q8.2, Q9.2, Q10.2, Q11.2, Q12.2, Q13.2, Q14.2, Q15.2, Q16.2, R7.2, R9.2, R11.2, R13.2, R14.2, R15.2, R18.2, R19.2, R20.2, R21.2, R22.2, R23.1, R24.2, R25.2, R26.2, R27.2, R28.2, R29.2, R31.2, R33.2, R35.2, R38.2, R40.2, R43.2, R45.2, R49.2, R52.2, R54.2, R56.2, U1.7, U1.22, U1.33, U1.47, U1.54, U1.65, U2.2, U3.3, U3.4, U4.3, U4.4, U5.1, U6.3
unnamed: C28.1, U4.7
unnamed: C28.2, L3.1, U4.6
unnamed: C31.1, C89.1, J60.A4, J60.A9, J60.B4, J60.B9, JP15.1
unnamed: C37.1, U3.7
unnamed: C37.2, L2.1, U3.6
unnamed: C48.1, FB3.1, U5.3
unnamed: C48.2, FB4.1, R23.2, U5.2
unnamed: C49.1, IC1.8
unnamed: C50.1, IC1.6
unnamed: C51.1, IC1.5
unnamed: C51.2, IC1.4
unnamed: C55.1, C56.1, C57.1, D19.1, F3.1, J11.1
unnamed: C62.1, C63.1, C65.1, D18.1, F2.1, J11.3
unnamed: C64.1, J12.1, JP4.1
unnamed: C67.1, J13.1, JP7.1
unnamed: C68.1, J14.1, JP10.1
unnamed: C69.1, J15.1, JP13.1
unnamed: C70.1, J16.1, JP18.1
unnamed: C71.1, J17.1, JP21.1
unnamed: C72.1, J18.1, JP24.1
unnamed: C73.1, J19.1, JP27.1
unnamed: C74.1, J20.1, JP30.1
unnamed: C75.1, J21.1, JP33.1
unnamed: C76.1, J22.1, JP36.1
unnamed: C77.1, J23.1, JP39.1
unnamed: C78.1, IC1.24, J7.3
unnamed: C80.1, IC1.21, J7.4
unnamed: C81.1, IC1.26, J7.2
unnamed: C82.1, IC1.1, J7.1
unnamed: C85.1, IC2.8
unnamed: C86.1, IC2.6
unnamed: C87.1, IC2.5
unnamed: C87.2, IC2.4
unnamed: C90.1, IC2.24, J8.3
unnamed: C91.1, IC2.21, J8.4
unnamed: C92.1, IC2.26, J8.2
unnamed: C93.1, IC2.1, J8.1
unnamed: C96.1, IC3.8
unnamed: C97.1, IC3.6
unnamed: C98.1, IC3.5
unnamed: C98.2, IC3.4
unnamed: C101.1, IC3.24, J9.3
unnamed: C102.1, IC3.21, J9.4
unnamed: C103.1, IC3.26, J9.2
unnamed: C104.1, IC3.1, J9.1
unnamed: C107.1, IC4.8
unnamed: C108.1, IC4.6
unnamed: C109.1, IC4.5
unnamed: C109.2, IC4.4
unnamed: C112.1, IC4.24, J10.3
unnamed: C113.1, IC4.21, J10.4
unnamed: C114.1, IC4.26, J10.2
unnamed: C115.1, IC4.1, J10.1
unnamed: D1.1, Q1.2, R8.2, R9.1
unnamed: D2.2, LS1.2, Q2.3
unnamed: D3.2, R4.2
unnamed: D4.1, R14.1
unnamed: D5.2, R5.2
unnamed: D18.2, J11.4, Q4.3
unnamed: D19.2, J11.2, Q5.3
unnamed: F1.1, Q1.3
unnamed: FB1.2, J60.S1
unnamed: FB3.2, J62.1
unnamed: FB4.2, J62.2
unnamed: IC1.23, R20.1
unnamed: IC1.27, R19.1
unnamed: IC2.23, R25.1
unnamed: IC2.27, R24.1
unnamed: IC3.23, R27.1
unnamed: IC3.27, R26.1
unnamed: IC4.23, R29.1
unnamed: IC4.27, R28.1
unnamed: J5.1, U1.3
unnamed: J12.3, JP3.1, Q3.3
unnamed: J13.3, JP6.1, Q6.3
unnamed: J14.3, JP9.1, Q7.3
unnamed: J15.3, JP12.1, Q8.3
unnamed: J16.3, JP17.1, Q9.3
unnamed: J17.3, JP20.1, Q10.3
unnamed: J18.3, JP23.1, Q11.3
unnamed: J19.3, JP26.1, Q12.3
unnamed: J20.3, JP29.1, Q13.3
unnamed: J21.3, JP32.1, Q14.3
unnamed: J22.3, JP35.1, Q15.3
unnamed: J23.3, JP38.1, Q16.3
unnamed: J25.1, U1.36
unnamed: J26.1, U1.51
unnamed: J31.1, U1.49
unnamed: J32.1, U1.50
unnamed: J33.1, U1.59
unnamed: J34.1, U1.60
unnamed: J60.A5, R22.1
unnamed: J60.B5, R21.1
unnamed: JP2.1, JP3.2, R6.2
unnamed: JP2.2, Q3.1, R7.1
unnamed: JP5.1, JP6.2, R30.2
unnamed: JP5.2, Q6.1, R31.1
unnamed: JP8.1, JP9.2, R32.2
unnamed: JP8.2, Q7.1, R33.1
unnamed: JP11.1, JP12.2, R34.2
unnamed: JP11.2, Q8.1, R35.1
unnamed: JP14.1, JP17.2, R36.2
unnamed: JP14.2, Q9.1, R38.1
unnamed: JP19.1, JP20.2, R39.2
unnamed: JP19.2, Q10.1, R40.1
unnamed: JP22.1, JP23.2, R41.2
unnamed: JP22.2, Q11.1, R43.1
unnamed: JP25.1, JP26.2, R44.2
unnamed: JP25.2, Q12.1, R45.1
unnamed: JP28.1, JP29.2, R47.2
unnamed: JP28.2, Q13.1, R49.1
unnamed: JP31.1, JP32.2, R51.2
unnamed: JP31.2, Q14.1, R52.1
unnamed: JP34.1, JP35.2, R53.2
unnamed: JP34.2, Q15.1, R54.1
unnamed: JP37.1, JP38.2, R55.2
unnamed: JP37.2, Q16.1, R56.1
unnamed: Q2.1, R16.1
unnamed: Q4.2, R2.1
unnamed: Q5.2, R3.1
unnamed: R2.2, U6.7
unnamed: R3.2, U6.5
unnamed: R11.1, U4.2
unnamed: R12.2, R13.1, U4.1
unnamed: R15.1, U3.2
unnamed: R17.2, R18.1, U3.1
