wrieden/c3dpb/hotend_board_mosquito/cubemx/cubemx.ioc

Mcu.UserName=STM32G431KBUx
PA0.Signal=COMP3_INP
PA1.Signal=OPAMP1_VINP
PA10.Signal=S_TIM1_CH3
PA11.Signal=USB_DM
PA12.Signal=USB_DP
PA13.Signal=SYS_JTMS-SWDIO
PA14.Signal=SYS_JTCK-SWCLK
PA15.Signal=SPI1_NSS
PA2.Signal=ADC1_IN3
PA3.Signal=OPAMP1_VINM0
PA4.Signal=COMP_DAC11_group
PA5.Signal=OPAMP2_VINM0
PA6.Signal=ADC2_IN3
PA7.Signal=OPAMP2_VINP
PA8.Signal=S_TIM1_CH1
PA9.Signal=S_TIM1_CH2
PB0.Signal=COMP4_INP
PB3.Signal=SPI1_SCK
PB4.Signal=SPI1_MISO
PB5.Signal=SPI1_MOSI
PB6.GPIO_Label=buck2_switch
PB6.Signal=S_TIM4_CH1
PB7.GPIO_Label=buck1_switch
PB7.Signal=S_TIM3_CH4
PB8-BOOT0.GPIO_Label=hearter_switch
PB8-BOOT0.Signal=S_TIM8_CH2
