wrieden/c3dpb/(commit log)

2019-06-15 initial, replaced dc dc
    [c3dpb.kicad_pcb, c3dpb.sch, driver.sch, interface.sch, output.sch, power.sch, single_driver.sch]
2019-06-16 replaced stepper driver
    [c3dpb.sch, driver.sch, interface.sch, output.sch, power.sch, single_driver.sch]
2019-06-30 power reg
    [c3dpb.kicad_pcb, output.sch, power.sch]
2019-07-20 new con
    [c3dpb.kicad_pcb, c3dpb.sch, io.sch, io_rev.sch, med_power.sch, output.sch, peripheral.sch, power.sch]
2019-08-10 pcb v1
    [c3dpb-B_Cu.gbr, c3dpb-B_Mask.gbr, c3dpb-B_SilkS.gbr, c3dpb-Edge_Cuts.gbr, c3dpb-F_Cu.gbr, c3dpb-F_Mask.gbr, c3dpb-F_SilkS.gbr, c3dpb-NPTH.drl]
2020-02-15 pcb version 1.1
    [c3dpb-B_Cu.gbr, c3dpb-B_Mask.gbr, c3dpb-B_SilkS.gbr, c3dpb-Edge_Cuts.gbr, c3dpb-F_Cu.gbr, c3dpb-F_Mask.gbr, c3dpb-F_SilkS.gbr, c3dpb-NPTH.drl]
2020-03-16 remove klipper submodule
2020-03-16 added klipper submodule
2020-03-16 added config
    [printer.cfg]
2020-03-29 hotend board
    [c3dpb.kicad_pcb, c3dpb.sch, fandriver.sch]
2020-03-29 hotend board v1.0
    [c3dpb-B_Cu.gbr, c3dpb-B_Mask.gbr, c3dpb-B_SilkS.gbr, c3dpb-Edge_Cuts.gbr, c3dpb-F_Cu.gbr, c3dpb-F_Mask.gbr, c3dpb-F_SilkS.gbr, c3dpb-NPTH.drl]
2020-03-29 value fixes
    [c3dpb.sch, fandriver.sch]
2023-03-31 idk backup...
    [c3dpb-B_Cu.gbr, c3dpb-B_Mask.gbr, c3dpb-B_SilkS.gbr, c3dpb-Edge_Cuts.gbr, c3dpb-F_Cu.gbr, c3dpb-F_Mask.gbr, c3dpb-F_SilkS.gbr, c3dpb-NPTH.drl]
